4eef/WaveformGenerator/Media/appearance.JPG

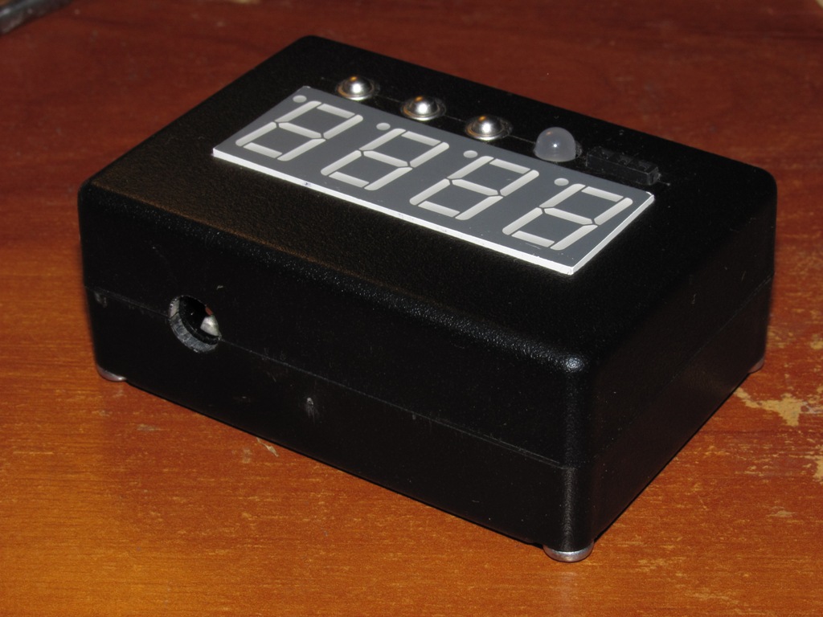
Media/appearance.JPG
