4eef/WaveformGenerator/Media/body-machinning.JPG

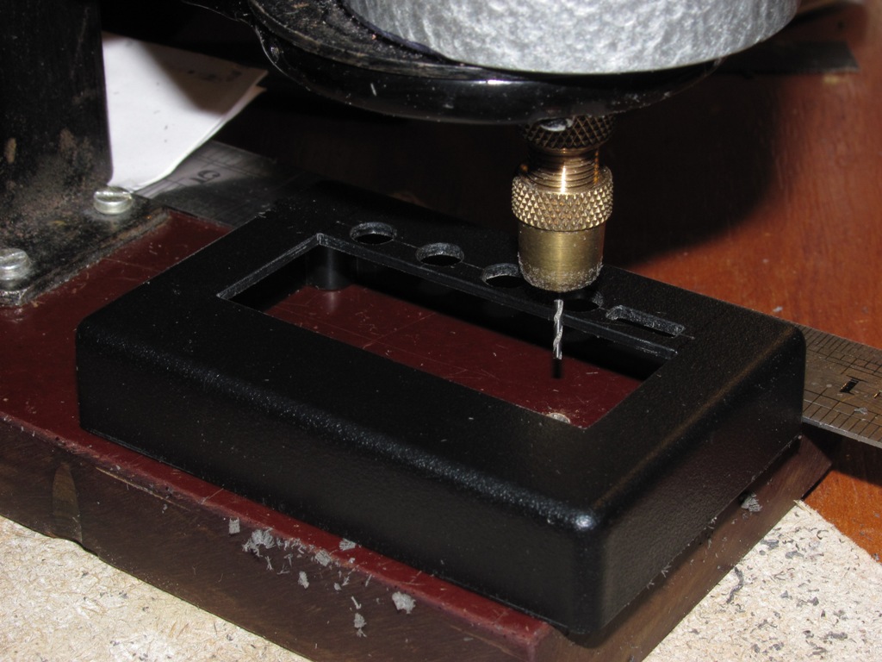
Media/body-machinning.JPG
