4eef/WaveformGenerator/Readme.txt

DDS Waveform Generator (July-September 2012)

Русский:

Проект является первым этапом обновления парка оборудования технических лабораторий ВУЗа по собственной инициативе. Разработка аппаратной и программной части произведена с учетом требований заданий в практических работах. Готовые изделия оформлены в виде малогабаритного коробка с выведенными органами управления для установки нужной формы и частоты сигнала, двухцветным светодиодом для опознавания установленной формы сигнала, и табло с семи-сегментными индикаторами для индицирования установленной частоты. Для запитки устройства необходимо подключить источник питания с параметрами 9 В и нагрузочной способностью не менее 1 А. После включения источника питания устройство готово к работе.
Генератор стандартных сигналов выполнен на основе микроконтроллера AVR ATmega48 и DDS-генератора. Выходные параметры изделия:
- синусоидальная, треугольная и меандровая формы сигнала;
- Диапазон рабочих частот - 0...10 кГц с шагом 1 Гц;
- фиксированная амплитуда сигнала 5 В;
- защита от короткого замыкания.

English:

Project was designed and developed as experimental equipment for higher school laboratory. Firmware development was done with taking into account requirements in the lab exercises. Device has a formfactor of compact box with outputted controls to set needed signal waveform and its frequency, and display units to show set wavefowm and its frequency by means of two-color LED and 7-segment LED indicator respectively. External power supply unit with parameters of 9V @ 1A is used to provide power for generator. After connecting power supply device is ready to operation.
Waveform generator is based on DDS-generator and AVR ATmega48 microcontroller. Output parameters:
- sinusoidal, triangular, or square waveform output;
- output frequency range is 0...10 kHz with 1 Hz resolution;
- fixed 0...5V signal amplitude;
- short circuit protection.
