4eef/WaveformGenerator/Hardware/scheme.gif

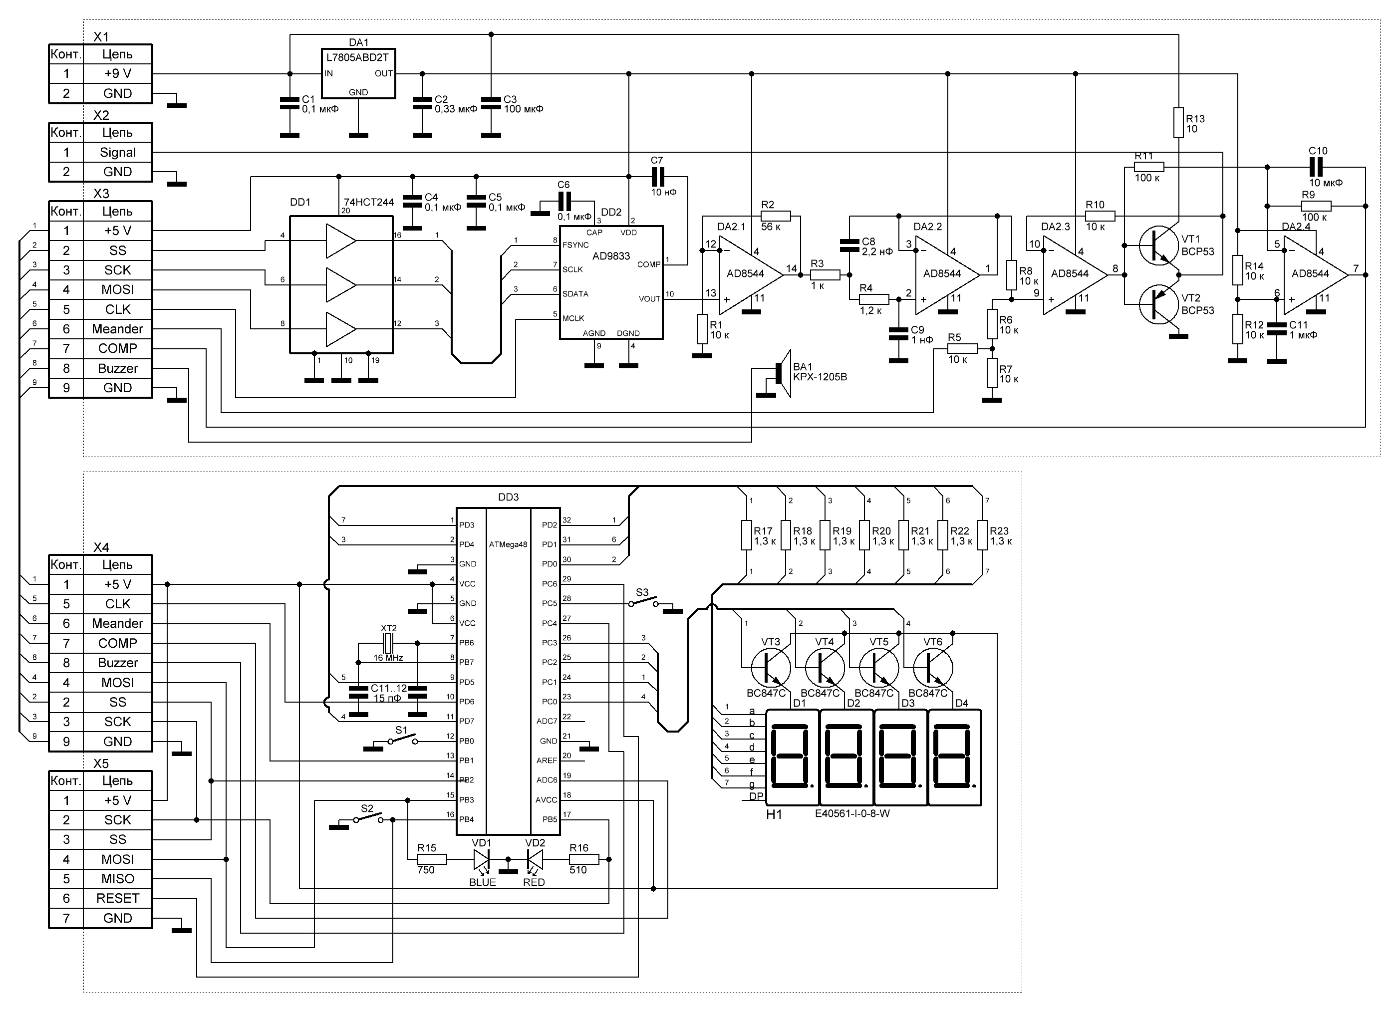
Hardware/scheme.gif
