4eef/WaveformGenerator/Media/pcbs.JPG

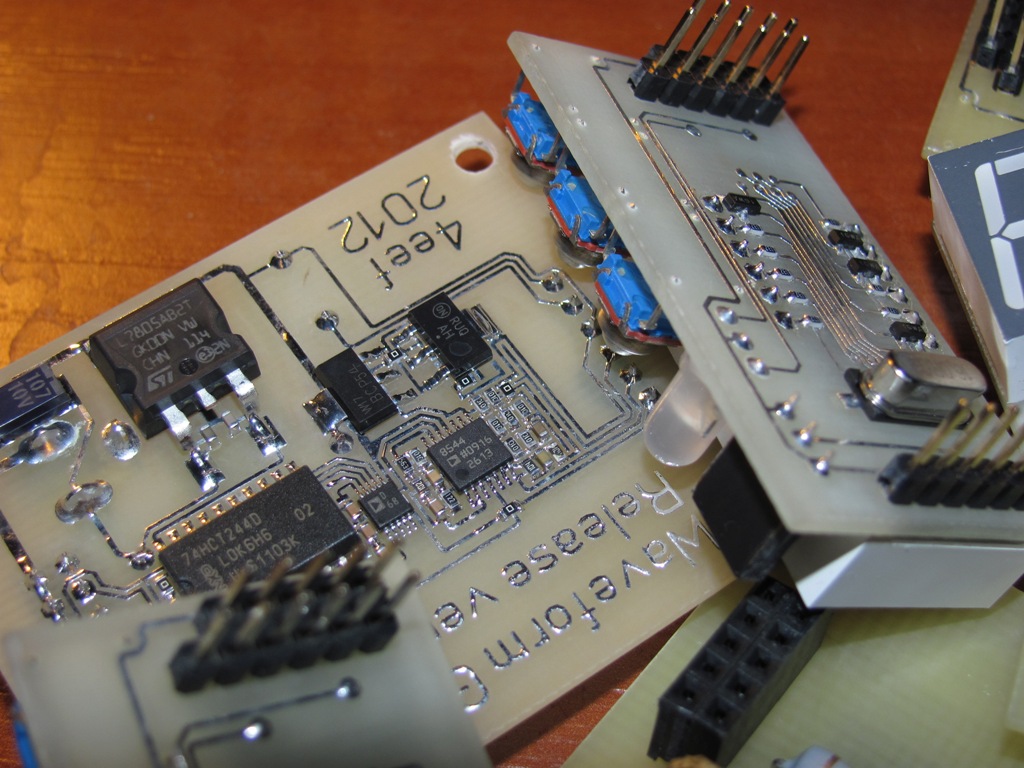
Media/pcbs.JPG
