4eef/WaveformGenerator/Media/working.JPG

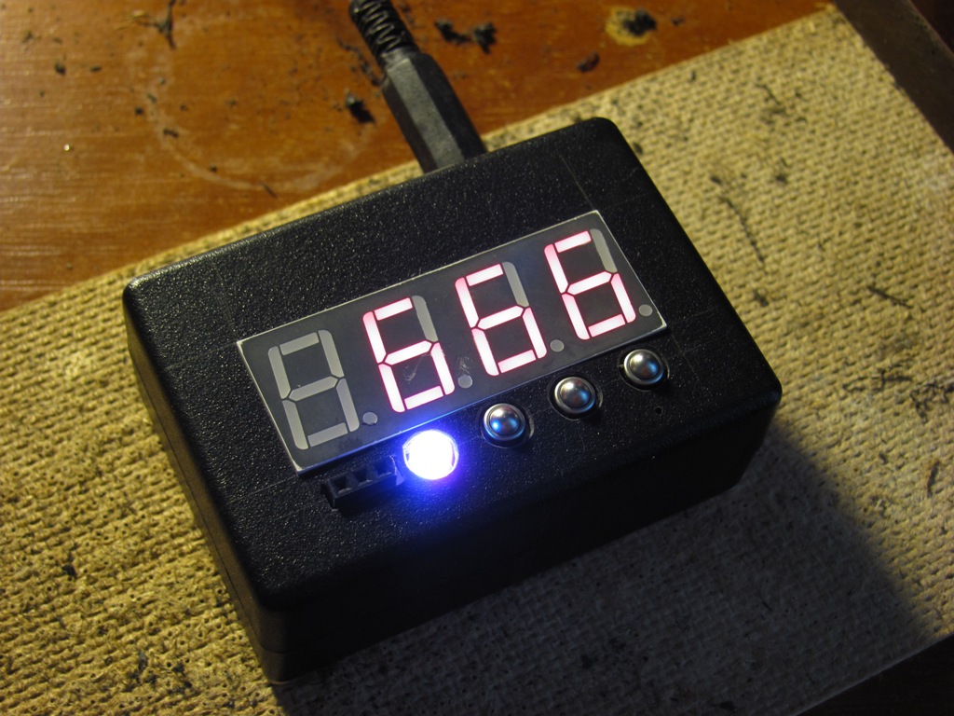
Media/working.JPG
