4eef/WaveformGenerator/(list of files, drawings)

Other design files:
Hardware/Waveform Generator.lay
